Bastardkb/Elite-C-holder/readme.md

## Holder PCB for the Elite-C

Universal holder PCB for all Bastard Keyboards

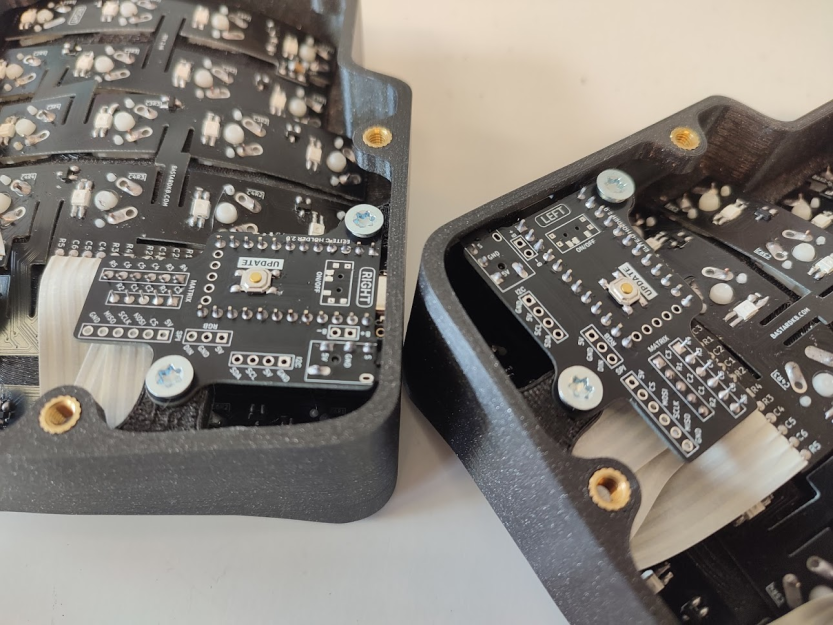
[picture p1: pics/2.png]
holder


## Optional features

- handedness resistor: 5.1k on R6, use pin F1
- I2C: install 4.7k resistors on R2 and R4
- on/off switch: use MSK-12C01-07

## Forks

[Holiot carrier](https://github.com/vattern/holiot-carrier) for bluetooth

[Splinktegrated](https://github.com/bastardkb/splinktegrated) - Integrated rp2040 and usb-c daughterboard 

[Blackpill holder](https://github.com/Bastardkb/adapter-blackpill/)

[Nice!nano holder](https://github.com/victorlucachi/Elite-C-holder)

# License 

This work is licensed under a Creative Commons Attribution-NonCommercial-ShareAlike 4.0 International License.
