Bastardkb/Elite-C-holder/pics/1.jpg

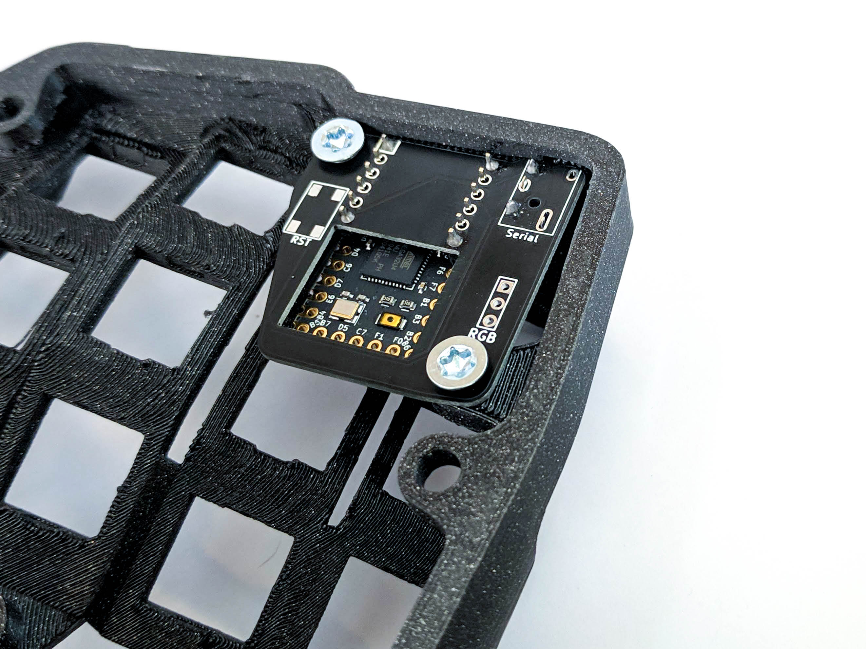
pics/1.jpg
