Bastardkb/Elite-C-holder/(threads)

Thread 3 (2022-04-25):

Floating .Fab layers?

mr-september, 2022-04-25:
Seeing this on KiCAD:

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

Is this anything to be concerned about?

mr-september, 2022-05-17:
bump?

bstiq, 2022-05-17:
Hi, oops missed that.
Can be safely ignored, just old adapter edge cuts for reference.

Closed 2022-05-17.

Thread 5 (2023-11-21):

What does the handedness resistor actually do?

Max585t, 2023-11-21:
Im making a version of the Elite-C holder that uses RJ9 jacks instead of 3.5mm jacks. With this change, Im changing the halves to communicate with i2c rather than serial. Im not sure if I need to keep the handedness resistor or not

bstiq, 2023-11-22:
Hello,

The handedness resistor is optional, and will pull a pin to GND on one side, to VCC on the other side.
This is not supported in the default firmware, you will need to enable the appropriate option and recompile it.

Closed 2023-11-22.
