Bastardkb/Elite-C-holder/(commit log)

2021-07-14 silkscreen logos and L/R
    [adapter.kicad_pcb]
2021-07-15 refill zones
    [adapter.kicad_pcb]
2021-07-31 silkscreen and edge cuts
    [adapter.kicad_pcb]
2022-02-12 edge cuts
    [adapter.kicad_pcb, adapter.kicad_sch]
2022-02-12 place header connectors
    [adapter.kicad_pcb, adapter.kicad_sch]
2022-02-13 move rst button
    [adapter.kicad_pcb, adapter.kicad_sch]
2022-02-13 add i2c pullups
    [adapter.kicad_pcb, adapter.kicad_sch]
2022-02-13 license stuff
    [adapter.kicad_pcb, adapter.kicad_sch]
2022-02-13 header placement
    [adapter.kicad_pcb, adapter.kicad_sch]
2022-02-13 power cleanup
    [adapter.kicad_pcb, adapter.kicad_sch]
2022-02-13 add jumpers
    [adapter.kicad_pcb, adapter.kicad_sch]
2022-02-13 serial and battery connectors
    [adapter.kicad_pcb, adapter.kicad_sch]
2022-02-13 add resistor values
    [adapter.kicad_pcb, adapter.kicad_sch]
2022-02-14 clear up schematic
    [adapter.kicad_sch]
2022-02-14 routing cleanup
    [adapter.kicad_pcb]
2022-02-14 new edge cuts
    [adapter.kicad_pcb]
2022-02-14 fixed edge cuts
    [adapter.kicad_pcb]
2022-02-14 battery connector
    [adapter.kicad_pcb, adapter.kicad_sch]
2022-02-15 Added MSK12C02 power switch footprints
    [adapter.kicad_pcb, adapter.kicad_sch]
2022-02-15 i2c labels
    [adapter.kicad_pcb]
2022-02-15 add 4 pin connectors for i2c (wip)
    [adapter.kicad_pcb, adapter.kicad_sch]
2022-02-16 .6/.3 vias
    [adapter.kicad_pcb]
2022-02-16 connect i2c ports
    [adapter.kicad_pcb]
2022-02-16 zones, small fixes
    [adapter.kicad_pcb]
2022-03-03 add ss pin
    [adapter.kicad_sch]
2022-03-03 add handedness resistor
    [adapter.kicad_pcb, adapter.kicad_sch]
2022-03-10 switch sda scl
    [adapter.kicad_pcb, adapter.kicad_sch]
2022-09-19 re-routing with 0.2mm
    [adapter.kicad_pcb]
2022-09-20 connect split hand pins
    [adapter.kicad_pcb]
