Bastardkb/Elite-C-holder/(notices)

Notices in the files:
adapter/adapter.kicad_pcb:
CERN-OHL-W v2
adapter/adapter.kicad_sch:
Licensed under CERN-OHL-W v2
